marcoreps/5700A/README.md

# 5700A

Some repair notes and reconstructions of Fluke 5700A
