marcoreps/5700A/frame enclosure etc/5700A handle.step

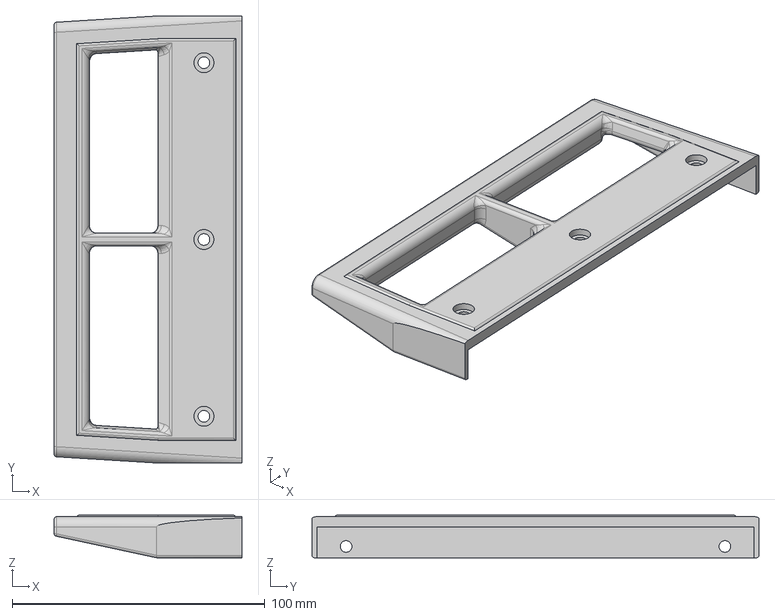
[picture p1: CAD file, 2020-03-20]
frame enclosure etc/5700A handle.step
74.3 x 177.0 x 16.9 mm
