marcoreps/5700A/(list of files, cad)

Other CAD files:
frame enclosure etc/5700A handle.f3d
frame enclosure etc/5700A handle.stl
