marcoreps/5700A/settling_time/csv/settling_test_10NPLC_180capture_20260226-122519.csv

Elapsed_Time | Voltage
5.6110002333298326e-06 | 1.935860328
0.429488797999511 | 5.993184402
0.8594166059992858 | 5.999989684
1.2892126200003986 | 6.000009121
1.718872380999528 | 6.000013962
2.147566311999981 | 6.000016138
2.576456684999357 | 6.000018358
3.005957600000329 | 6.000018713
3.4353426309990027 | 6.000021008
3.864703330998964 | 6.000020519
4.293773796000096 | 6.000021156
4.724364137999146 | 6.000021659
5.155596725000578 | 6.000022207
5.58686127799956 | 6.000021733
6.016375036000682 | 6.000022148
6.445973665000565 | 6.000022444
6.875794993000454 | 6.000021437
7.305212385999766 | 6.000022103
7.734475895998912 | 6.00002234
8.163639704000161 | 6.000022533
8.592697963000319 | 6.000020993
9.021760350999102 | 6.000022666
9.451084086000265 | 6.000021674
9.880372027999329 | 6.00002197
10.30991001899929 | 6.000021126
10.73859808799898 | 6.000022237
11.167809811999177 | 6.000022533
11.597901335000643 | 6.000021704
12.028898171000037 | 6.000022592
12.458452282000508 | 6.000022414
12.888246460999653 | 6.000022858
13.317327824999666 | 6.000021837
13.746622315000423 | 6.000020801
14.175676680999459 | 6.000021867
14.60482719599895 | 6.000021274
15.034026745999654 | 6.000020712
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
