marcoreps/5700A/settling_time/csv/settling_test_1NPLC_180capture_20260226-120107.csv

Elapsed_Time | Voltage
3.000000106112566e-06 | 1.000004607
0.06932088100074907 | 1.000005495
0.1393656420004845 | 3.092551603
0.21019318900016515 | 5.126538609
0.2812368630002311 | 5.741363731
0.352086003000295 | 5.923625945
0.4228465510004753 | 5.97731731
0.4935374700007742 | 5.993203663
0.5639955780006858 | 5.997935507
0.6343897229999129 | 5.999359131
0.7048977560007188 | 5.999792272
0.7751560140004585 | 5.999925353
0.8457863230005387 | 5.999971687
0.9159982300006959 | 5.999988119
0.9868374070001664 | 5.999996556
1.0571379060002073 | 6.000000553
1.1268401520001134 | 5.999999961
1.1969003210006122 | 6.000003662
1.2663782370000263 | 6.000003218
1.335149773000012 | 6.000008695
1.4042162870000539 | 6.000007955
1.472843233000276 | 6.000008695
1.5415761960002783 | 6.000009583
1.6104993779999859 | 6.000009287
1.679425098000138 | 6.000011508
1.7485011680000753 | 6.000011508
1.8176919580000686 | 6.000015208
1.886553049000213 | 6.000014024
1.9551643100003275 | 6.000014024
2.023862605999966 | 6.000015208
2.093141488000583 | 6.000015653
2.1631512869998915 | 6.000016097
2.2330331789999036 | 6.000015801
2.3021388600000137 | 6.000017577
2.3708415080000123 | 6.000016393
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
