marcoreps/5700A/settling_time/csv/settling_test_1NPLC_180capture_20260226-120800.csv

Elapsed_Time | Voltage
6.036998456693254e-06 | 1.000003867
0.0697971179997694 | 1.000003867
0.13941433699983463 | 3.080970169
0.20941520599990326 | 5.111952421
0.2805553359994519 | 5.739983184
0.35172885399879306 | 5.92370455
0.42157809999844176 | 5.976715559
0.49093185299898323 | 5.992879177
0.5606254059985076 | 5.997803462
0.6296634699992865 | 5.999303174
0.6986625919998914 | 5.999770512
0.7677468019992375 | 5.99991884
0.8370504839986097 | 5.999968578
0.9125678059990605 | 5.999987082
0.9818403779991058 | 5.999996112
1.051297922998856 | 5.999998185
1.1206738969995058 | 5.999999517
1.190093851999336 | 6.000004402
1.258762173998548 | 6.000004698
1.3281102789987926 | 6.00000529
1.397345907998897 | 6.000007955
1.4660088639993774 | 6.000008843
1.53440705399953 | 6.000008547
1.6029578849993413 | 6.000012692
1.671744111999942 | 6.000010323
1.7403470709996327 | 6.000011656
1.8088602739990165 | 6.000014468
1.8773654959986743 | 6.00001432
1.9460035269985383 | 6.00001136
2.014657723999335 | 6.000014616
2.0832179069984704 | 6.000013876
2.1518939359993965 | 6.000015505
2.2207721039994794 | 6.000015356
2.289155756998298 | 6.000015949
2.357782769999176 | 6.000015653
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
