marcoreps/5700A/settling_time/csv/settling_test_1NPLC_180capture_20260226-121406.csv

Elapsed_Time | Voltage
3.388999175513163e-06 | 1.000003423
0.06849459300065064 | 1.000002683
0.13714858800085494 | 3.070299725
0.2060861850004585 | 5.08217563
0.27516162999927474 | 5.719171214
0.3441527260001749 | 5.914585481
0.41307980500096164 | 5.973874825
0.48210008400019433 | 5.991991873
0.5510629960008373 | 5.997520573
0.6200766830006614 | 5.999216428
0.6891064440005721 | 5.999743422
0.7580933909994201 | 5.999909958
0.8269780459995673 | 5.999965914
0.8961268029997882 | 5.999983086
0.9652606350009592 | 5.999993744
1.0342775829994935 | 5.999997297
1.1031310369999119 | 6.000001738
1.1716375569994852 | 5.999999961
1.2395230969996192 | 6.000004698
1.3081520020004973 | 6.000004994
1.376503342000433 | 6.000005586
1.4453057419996185 | 6.000010027
1.5134370520008815 | 6.000010768
1.5818709079994733 | 6.000010323
1.6504443520007044 | 6.000012248
1.719114384999557 | 6.000012396
1.7877381239995884 | 6.000013136
1.8564771180008393 | 6.000014912
1.9253508120000333 | 6.000014912
1.993889589999526 | 6.000014912
2.0623303550000855 | 6.000015208
2.131005446000927 | 6.000014616
2.19975662700017 | 6.000016393
2.2685350100000505 | 6.000015356
2.33714993600006 | 6.000016837
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
