marcoreps/5700A/settling_time/csv/settling_test_1NPLC_20260226-104224.csv

Elapsed_Time | Voltage
5.3880003179074265e-06 | 1.000001795
0.06859185300027093 | 1.000002091
0.13750879600002008 | 2.456606899
0.20663934800040806 | 4.915541158
0.27597754700036603 | 5.676295661
0.3464658490001966 | 5.905131416
0.4166801710002801 | 5.971675513
0.4859695740001371 | 5.9913805
0.554997072000333 | 5.997338493
0.6242129390002447 | 5.999163728
0.6933409180001036 | 5.999726546
0.762350045000403 | 5.999902112
0.8315114310003082 | 5.999959104
0.9003721900003256 | 5.999980865
0.9691294120002567 | 5.999991523
1.0380315590000464 | 5.999995076
1.107047891000093 | 6.00000159
1.1754901890003566 | 6.000002182
1.2441883380001855 | 6.000002182
1.3127768399999695 | 6.00000455
1.3815527280003153 | 6.000006771
1.4499507680002353 | 6.000008547
1.5184760670003925 | 6.000007807
1.587020902000404 | 6.000007659
1.6554697930000657 | 6.000008843
1.723978740000348 | 6.000010027
1.792526927000381 | 6.000011212
1.8612536690002344 | 6.000012988
1.9296340240002792 | 6.000011952
1.9981412850002016 | 6.00001284
2.0668411560000095 | 6.000013876
2.135433213000397 | 6.000014172
2.204050307000216 | 6.000013728
2.272892177000358 | 6.000013728
2.341783380000379 | 6.000014024
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
