marcoreps/5700A/settling_time/csv/settling_test_1NPLC_20260226-104309.csv

Elapsed_Time | Voltage
3.1109998417377938e-06 | 1.000003275
0.06878819299981842 | 1.000001499
0.13738236799963488 | 2.8892268
0.20654702100000577 | 5.025816729
0.27558221099980074 | 5.703814667
0.3446396609997464 | 5.910186857
0.413420890999987 | 5.972612112
0.4823796939999738 | 5.991628602
0.5514170329997796 | 5.997416358
0.6204440009996688 | 5.999184897
0.689433266999913 | 5.999732763
0.7589484169998286 | 5.999905813
0.827956236999853 | 5.999963249
0.8970818719999443 | 5.999982789
0.9663650610000332 | 5.999992264
1.0353724560000046 | 5.99999478
1.1042416479999702 | 5.999998037
1.1731801359997007 | 5.999999665
1.2421287349998238 | 6.000002478
1.3106631149998975 | 6.00000529
1.3791738840000107 | 6.000005438
1.4477895779996288 | 6.000004994
1.5162737179998658 | 6.000008399
1.584698042999662 | 6.000008843
1.6530687389999912 | 6.000008991
1.7214757499996267 | 6.000011064
1.7901071849996697 | 6.000011656
1.8589063409999653 | 6.000010768
1.9273549619997539 | 6.000014912
1.9962381539999114 | 6.000012692
2.064767886000027 | 6.000011952
2.1331877669999812 | 6.00001432
2.201767627999743 | 6.000013284
2.270563653999943 | 6.000014616
2.33918953400007 | 6.000014172
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
