marcoreps/5700A/(commit log)

2020-01-30 added 3003 keypad board
    [30003.kicad_pcb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]
2020-01-31 fixed 2 keepout areas
    [30003.kicad_pcb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]
2020-03-20 added enclosure handle
    [3003.kicad_pcb, 5700A handle.f3d, 5700A handle.stl]
2020-03-20 added stp file
    [5700A handle.step]
2020-07-03 handle changes and tantalum cap pdf added
    [5700A handle.f3d]
2020-10-31 added more clearance around screw holes
    [3003-B_Cu.gbr, 3003-B_Mask.gbr, 3003-B_SilkS.gbr, 3003-Edge_Cuts.gbr, 3003-F_Cu.gbr, 3003-F_Mask.gbr, 3003-F_SilkS.gbr, 3003.drl]
2021-07-29 Refreshed the 3 in / output relays to try and fix the 1 Ohm and 1.9 Ohm drifts
2021-08-03 Refilled the leaked relay fluid ( DeoxIt Gold ) of the three front in- / output relays.
2021-08-04 front relay repair seems successful!
2026-02-26 voltage settling time experiment
    [settling_test_1NPLC_20260226-104224.csv, settling_test_1NPLC_20260226-104309.csv, settling_test_1NPLC_20260226-104400.csv]
